ARPES-robotics/vacuum-suitcase/README.md

# vacuum-suitcase
Design of the vacuum suitcase for 10 Omicron slots to keep the samples in 10^-11 Torr preasure and be able to transfer then to CF60 flunge
