ARPES-robotics/vacuum-suitcase/Rendered_picture.JPG

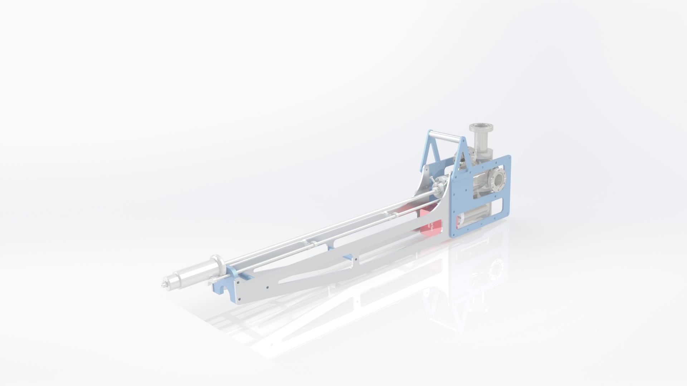
Rendered_picture.JPG
