ARPES-robotics/vacuum-suitcase/drawings/Vaccum Chamber.STEP

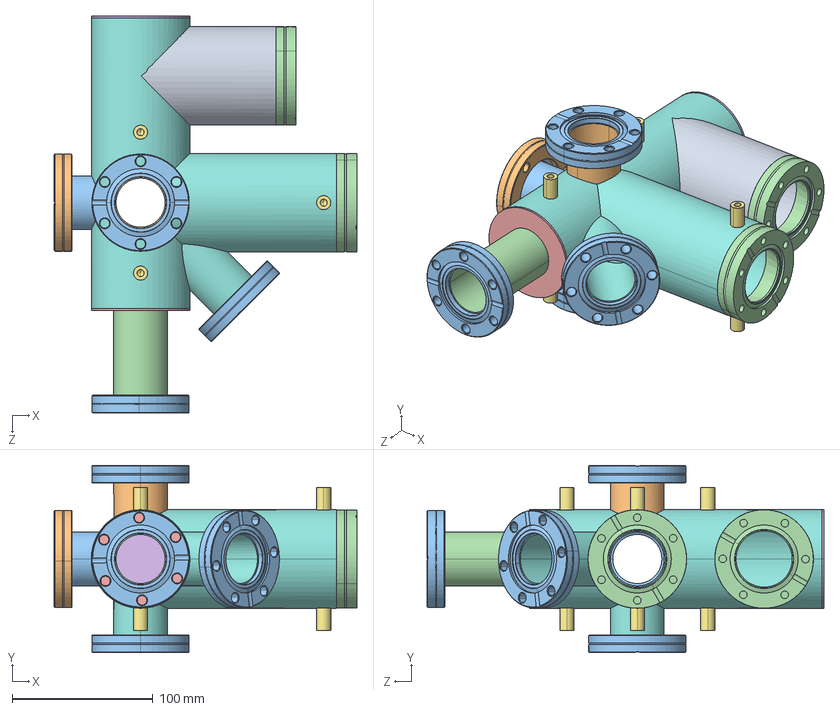
[picture p3: CAD file, 2022-12-01]
drawings/Vaccum Chamber.STEP
214.8 x 133.0 x 281.8 mm
Main Body Vacuum Chamber_Standard
F0275x150R_Standard
F0275x150N_Standard x 4
F0275X275WS_Standard x 2
