ARPES-robotics/vacuum-suitcase/(list of files, cad)

Other CAD files:
drawings/Frame/Frame_Base.SLDDRW
drawings/Frame/STC F AA0000.SLDDRW
drawings/Frame/STC F AA0001.SLDDRW
drawings/Frame/STC F AA0001_1.SLDDRW
drawings/Frame/STC F AA0002.SLDDRW
drawings/Frame/STC F AA0003.SLDDRW
drawings/Frame/STC F AA0004.SLDDRW
drawings/Frame/STC F AA0005.SLDDRW
drawings/Frame/STC F AA0006.SLDDRW
drawings/Frame/STC F AAXXXX_WELDMENTS.SLDDRW
