ARPES-robotics/vacuum-suitcase/drawings/Frame/STC F AA0000.PDF

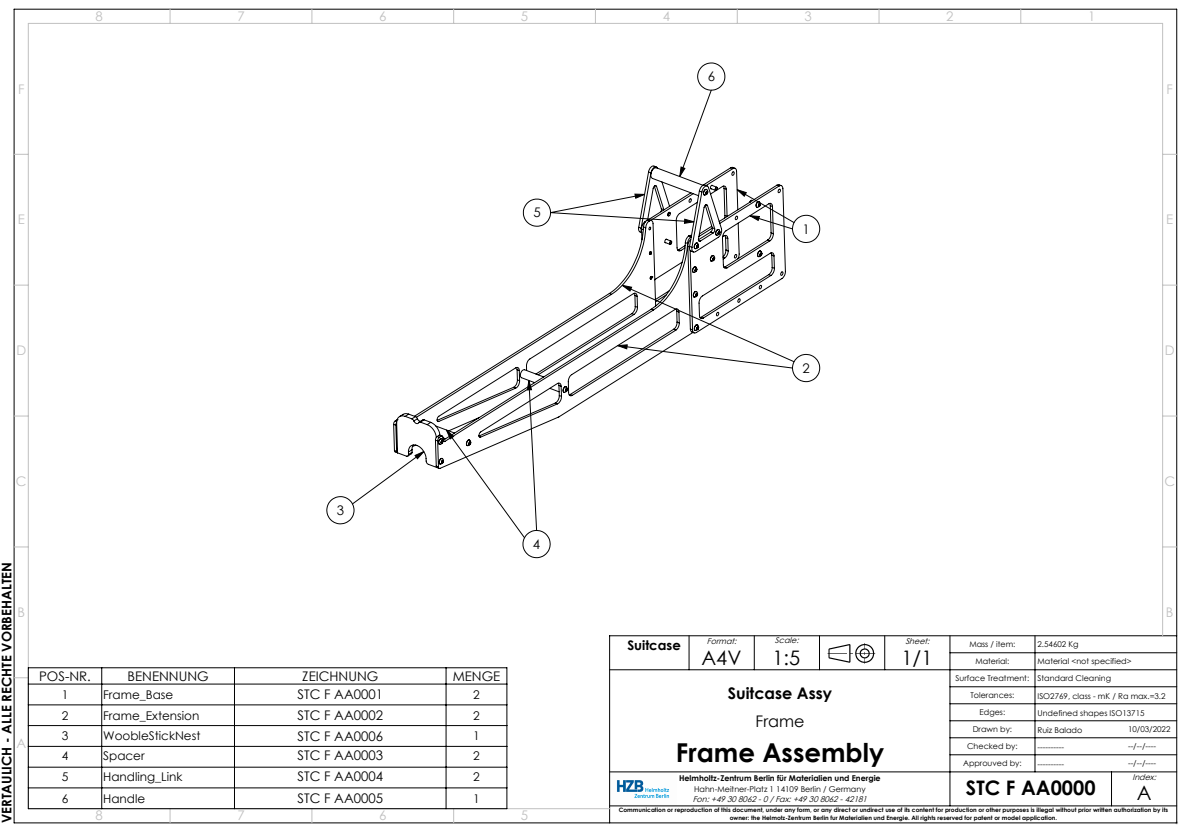
[picture p4: page 1]
Frame_Extension; STC F AA0002; Suitcase Assy Frame Assembly; Surface Treatment:; Undefined shapes ISO13715; Standard Cleaning

VERTAULICH - ALLE RECHTE VORBEHALTEN

Suitcase | Format: A4V | Scale: 1:5 | Sheet: 1/1 | Mass / item: | 2.54602 Kg

Material: | Material <not specified>

1 | Frame_Base | STC F AA0001 | 2

Tolerances: | ISO2769, class - mK / Ra max.=3.2

3 | WoobleStickNest | STC F AA0006 | 1
4 | Spacer | STC F AA0003 | 2
5 | Handling_Link | STC F AA0004 | 2
6 | Handle | STC F AA0005 | 1

Drawn by: | Ruiz Balado 10/03/2022
Checked by: | --/--/--------------
Approuved by: | ------------/--/----

Helmholtz-Zentrum Berlin für Materialien und Energie Hahn-Meitner-Platz 1 14109 Berlin / Germany Fon: +49 30 8062 - 0 / Fax: +49 30 8062 - 42181 | STC F AA0000 | Index: A

Communication or reproduction of this document, under any form, or any direct or undirect use of its content for production or other purposes is illegal without prior written authorization by its

owner: the Helmotz-Zentrum Berlin fur Materialien und Energie. All rights reserved for patent or model application.
