ARPES-robotics/vacuum-suitcase/drawings/Frame/STC F AA0001.PDF

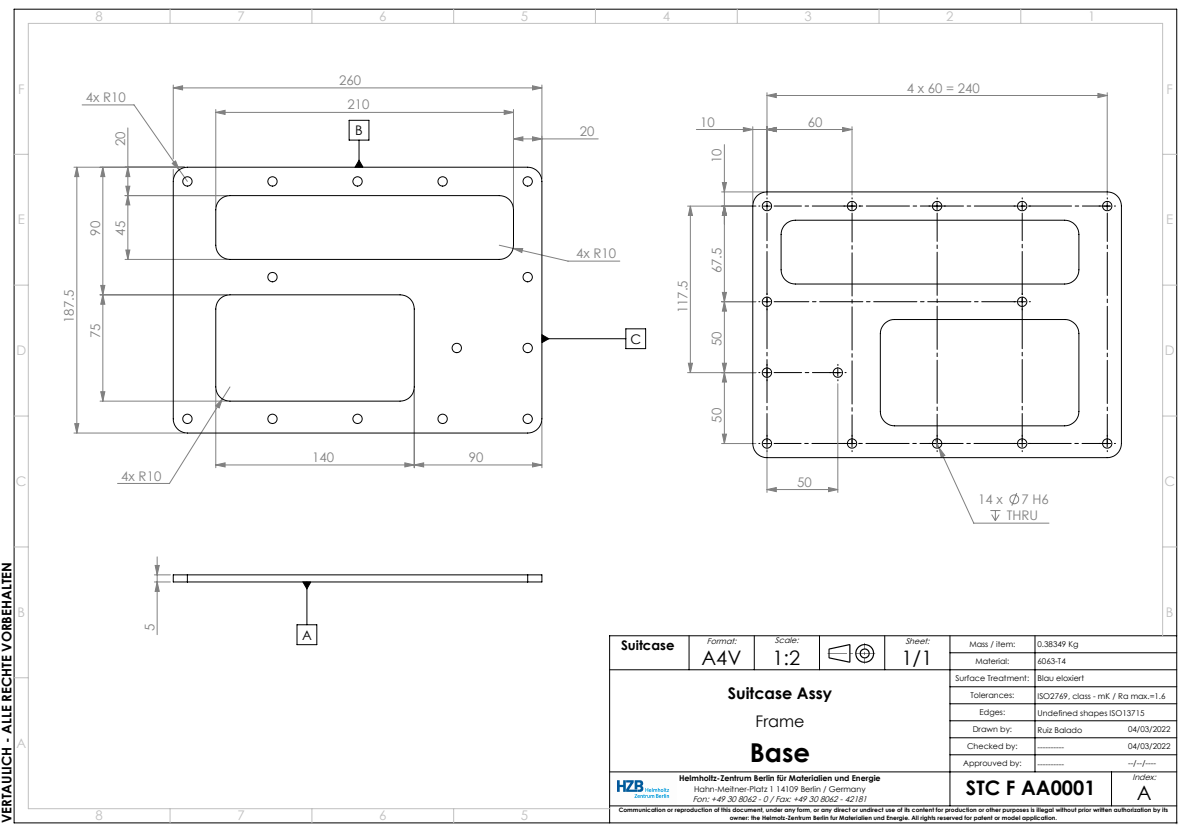
[picture p5: page 1]

VERTAULICH - ALLE RECHTE VORBEHALTEN

Suitcase | Format: A4V | Scale: 1:2 | Sheet: 1/1 | Mass / item: | 0.38349 Kg

Material: | 6063-T4

Suitcase Assy Frame Base | | | | Surface Treatment: | Blau eloxiert

Tolerances: | ISO2769, class - mK / Ra max.=1.6
Edges: | Undefined shapes ISO13715
Drawn by: | Ruiz Balado 04/03/2022
Checked by: | 04/03/2022 ----------
Approuved by: | ------------/--/----

Helmholtz-Zentrum Berlin für Materialien und Energie Hahn-Meitner-Platz 1 14109 Berlin / Germany Fon: +49 30 8062 - 0 / Fax: +49 30 8062 - 42181 | STC F AA0001 | Index: A

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
