ARPES-robotics/vacuum-suitcase/drawings/Frame/STC F AA0002.PDF

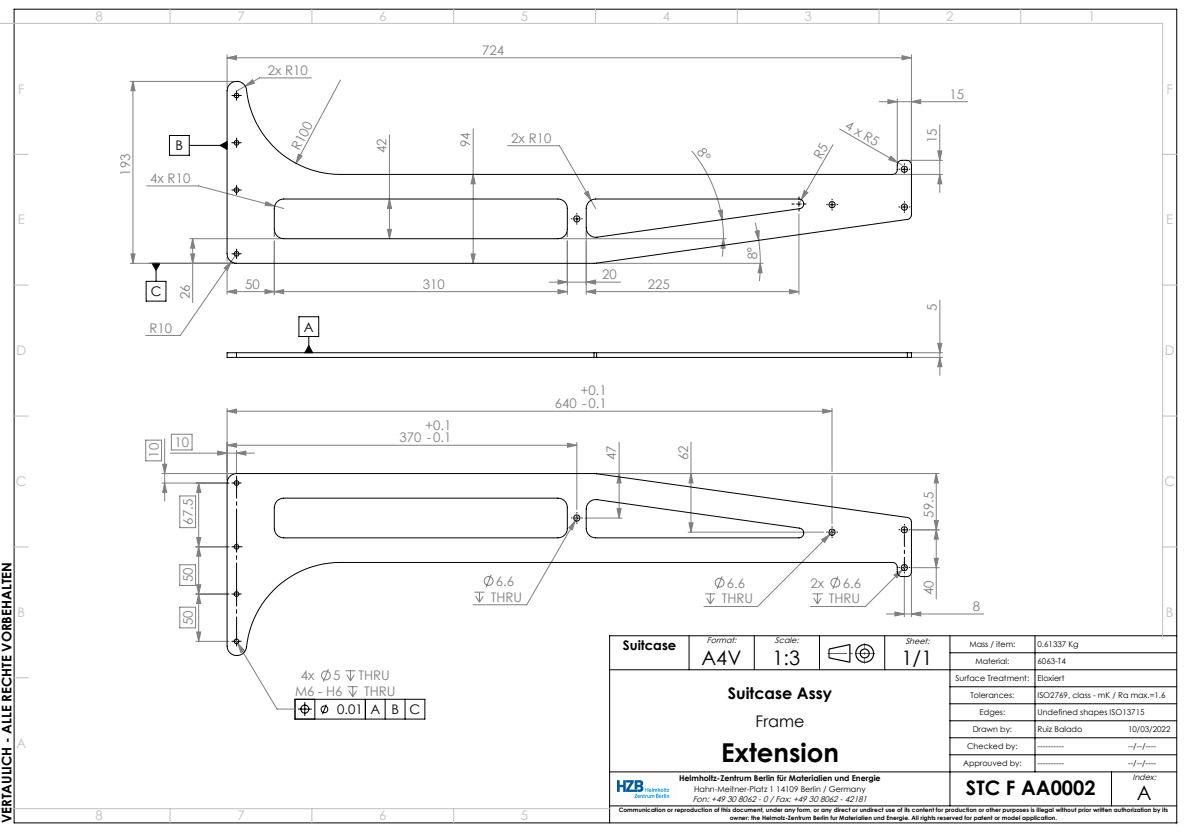
[picture p6: page 1]
4x 5 THRU M6 - H6 THRU

VERTAULICH - ALLE RECHTE VORBEHALTEN

Suitcase | Format: A4V | Scale: 1:3 | Sheet: 1/1 | Mass / item: | 0.61337 Kg

Material: | 6063-T4

Suitcase Assy Frame Extension | | | | Surface Treatment: | Eloxiert

Tolerances: | ISO2769, class - mK / Ra max.=1.6
Edges: | Undefined shapes ISO13715
Drawn by: | Ruiz Balado 10/03/2022
Checked by: | --/--/--------------
Approuved by: | ------------/--/----

Helmholtz-Zentrum Berlin für Materialien und Energie Hahn-Meitner-Platz 1 14109 Berlin / Germany Fon: +49 30 8062 - 0 / Fax: +49 30 8062 - 42181 | STC F AA0002 | Index: A

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
