ARPES-robotics/vacuum-suitcase/drawings/Frame/STC F AA0003.PDF

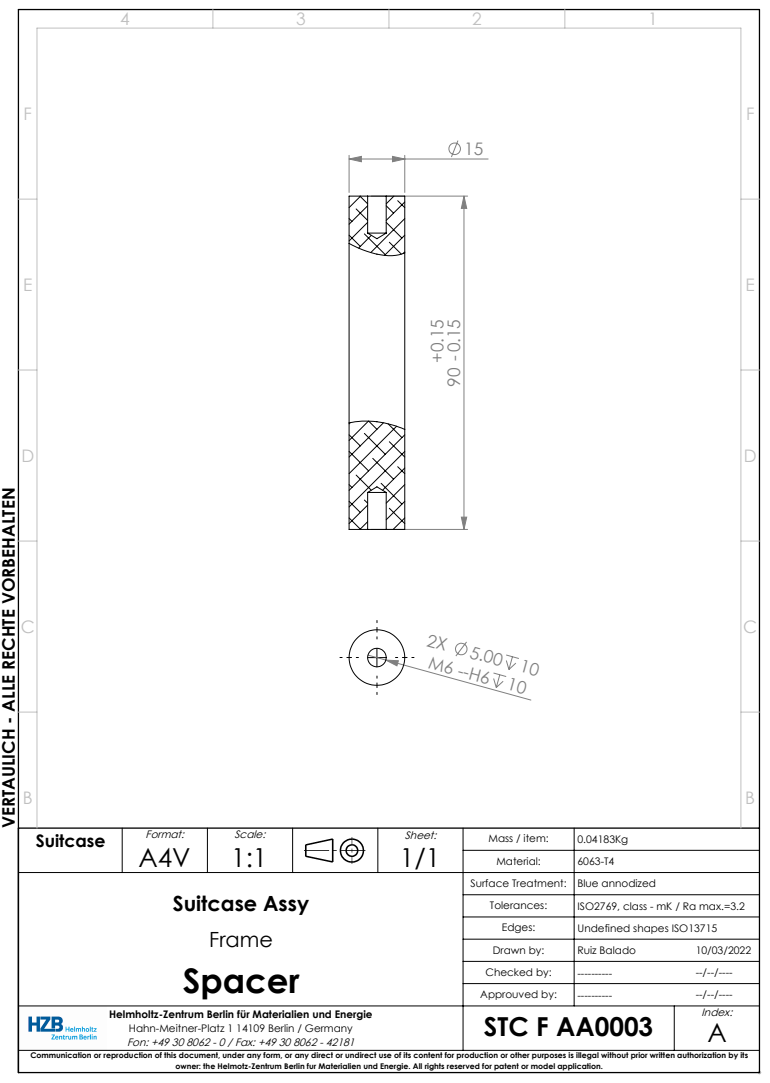
[picture p7: page 1]

VERTAULICH - ALLE RECHTE VORBEHALTEN

Suitcase | Format: A4V | Scale: 1:1 | Sheet: 1/1 | Mass / item: | 0.04183Kg

Material: | 6063-T4

Suitcase Assy Frame Spacer | | | | Surface Treatment: | Blue annodized

Tolerances: | ISO2769, class - mK / Ra max.=3.2
Edges: | Undefined shapes ISO13715
Drawn by: | Ruiz Balado 10/03/2022
Checked by: | --/--/--------------
Approuved by: | ------------/--/----

Helmholtz-Zentrum Berlin für Materialien und Energie Hahn-Meitner-Platz 1 14109 Berlin / Germany Fon: +49 30 8062 - 0 / Fax: +49 30 8062 - 42181 | STC F AA0003 | Index: A

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
