ARPES-robotics/vacuum-suitcase/(commit log)

2022-12-01 vacuum chamber in STP format
    vacuum chamber for 10 slots
    [Vaccum Chamber.STEP]
2022-12-01 Rendered picture of the suit case
2022-12-01 STP model for the frame
    [Frame.STEP]
